Robozor-network/Opticus/README.md

# Opticus

Opticus black line following robot. 

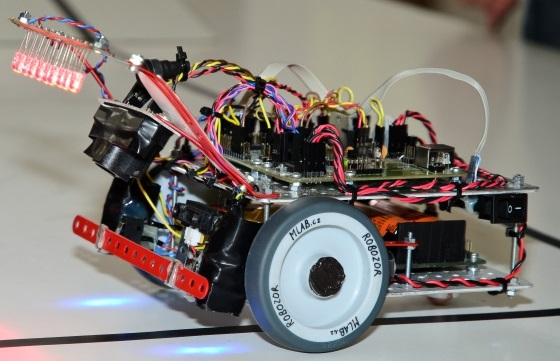
[picture p1: Opticus_Small.jpg]
Robot Opticus
