Robozor-network/Opticus/CAD/wheel.stl

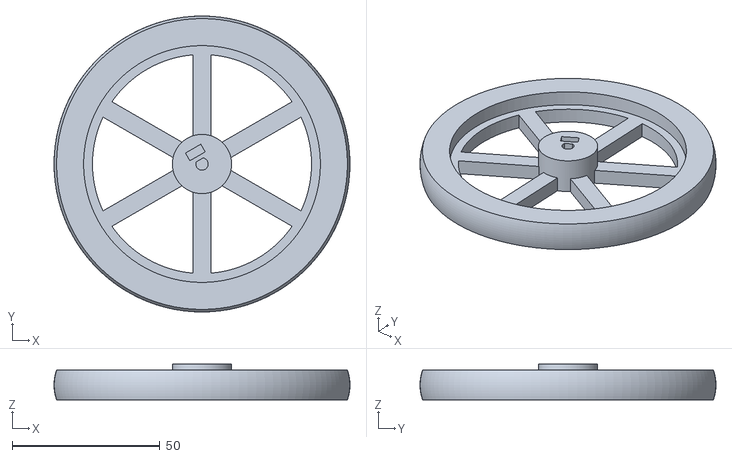
[picture p24: CAD file, 2015-09-17]
CAD/wheel.stl
100.0 x 100.0 x 12.0
