Robozor-network/Opticus/(commit log)

2013-12-01 sensor testing.
2013-12-02 testovaci program pro vycitani mereni ze sensoru.
2013-12-23 zalozeni nove dokumentacni slozky pro dvoukanalovy ADC.
2014-01-05 Hodinový PLL generátor s obvodem TI CDCE913 (schema, PCB a technologické výstupy).
2014-01-09 Opraven SCH a PCB CLK1PLL01A (oprava EN vývodů u stabilizátorů), nutno ještě přegenerovat PDF výstupy od plošného spoje (zde PDF995 generuje velmi nekvalitní výstupy, nutno použít něco funkčnějšího).
2014-02-04 ve firmwaru AWS odstranen aktualni cas. Je overena funkce i2c slave. Je treba doplnit relativni casove mereni. A aktualizaci registru.
2014-02-08 Nový modul AVRUSB01A pro SW realizaci USB na AVR, umí ISP programování, nebo USB na I2C
2014-02-15 Doladěny přepínače FUSE pro procesory ATmega8 a ATmega88
2014-02-23 zavedeni modulu i2chub.
2014-02-26 pridani navrhu v KiCAD.
2014-03-02 Původní verze firmwaru (pro referenci změn) i2c-tiny-usb pro modul AVRUSB01
2014-03-02 Upravená verze firmwaru i2c-tini-usb pro modul AVRUSB01
2014-03-02 Překlad firmwaru I2C pro AVRUSB01 (plus oprava pro překlad pod Linuxem)
2014-03-06 aktualizace kodu pro novou verzi I2C knihoven.
2014-03-10 pridani navrhu differencniho vstupu pro adc ve zvukovce.
2014-03-12 zaznam chyb na PCB.
2014-03-16 dokoncovani navrhu plosneho spoje pro FMC redukci (pridany koty). Zacatek navrhu modulu pro ADC.
2014-03-18 prvni optimalizace differencnich spoju. A prohozeni polarity vstupu ADC.
2014-03-19 pridani zapomenutych souboru a uprava skriptu pro prejmenovani vystupu z KiCADu.
2014-03-24 Added an utility for setting Si570 without frequency measurement. Factory calibration is used.
2014-03-30 pridani ipython navodu pro magnetometr.
2014-04-08 Přidána podpora jak společné anody tak i společné katody LED displeje.
2014-04-17 rozdeleni konstrukce AWS01B na novou vyvojovou vetev AWS02A, ktera se uz nepripojuje pres RS323, ale pres I2C.
2014-04-24 Uprava kodu pro puziti s Odroidem a I2C hubem.
2014-04-29 Dokumentace malého napájecího zdroje NTPI2EU 9V/500mA (rozpracováno)
2014-05-02 Dokumentace malého napájecího zdroje NTPI2EU 9V/500mA (dokončeno)
2014-05-25 I2C motor driver
2014-05-26 pridani regulatoru.
2014-06-07 add Fritzing GPS antenna
2014-06-16 pridani schema sensoru smeru vetru meteostanice.
2014-08-17 Pridan navod na regulator.
2014-08-21 schema I2CSPI
2014-10-25 Added LED heartbeat indicator.
2014-11-24 oprava zapojeni vstupnich konektoru ADC modulu.
2014-11-26 Added High Voltage Source for Gas Lamps
2014-11-30 Added values to schematic.
2014-12-08 Change of holes arrangement
2014-12-09 uprava pcb
2014-12-11 zaroutovani PCB.
2015-01-02 oprava chyby - misto pro kondenzatory na redukcnim PCB.
2015-01-11 zlepšeny tolerance PCB.
2015-01-16 editace podlozky pro lepsi geometrii a usetreni materialu.
2015-02-03 zlepseni dokumentace. Pokus o vytvoreni sablony KiCAD, ktera by umoznila kresleni plosnych spoju v prvnim kvadrantu.
2015-02-13 pridani dokumentacni slozky pro Raspberry Pi podlozku.
2015-02-15 prvni verze drzaku na raspberry Pi.
2015-02-16 pridan obrazek ramecku pro Raspberry.
2015-02-22 pridani obrazku pouziteho drzaku na Raspberry.
2015-03-06 zaroutovani casti PCB po posunuti der a okraje
2015-03-11 zmena pouzder u kondenzatoru a diod.
    V teto verzi je taky omylem aktualizovany footprint pro 2mm hrebinek, coz zpusobilo problem diky zmene cislovani.
2015-03-16 Prvni verze breakout frame pro Intel Galileo.
2015-03-19 Pridani fotky breakout frame pro Intel Galileo.
2015-03-25 upravy PCB a vygenerovani technologickych dat.
2015-03-25 doladeni routovani PCB.
2015-04-06 Modernizace PCB.
2015-04-23 Better LED status indication.
2015-05-04 upravy popisku a cest pro lepsi vedeni GND.
2015-06-18 ADC version of dosimeter
2015-06-19 shorten LED blink
2015-07-18 An temperature real time plot using HTML5
2015-08-17 okotovani PCB.
2015-08-27 USBHUB01A PCB
2015-09-08 zalozeni noveho modulu pro tenzometricky ADC.
2015-09-10 Uprava tisknutelneho kola pro prisroubovani na D-cut.
    [wheel.scad, wheel.stl]
2015-09-11 drobne opravy PCB.
2015-09-14 upravy rozmeru kola podle skutecneho vytisku.
    [wheel.scad]
2015-09-15 Modifikace kola pro snadnejsi tisk.
    [wheel.scad, wheel.stl]
2015-09-15 Posunuti PCB do stredu stranky pri tisk dokumentace.
2015-09-16 uprava parametru kola pro lepsi tisk.
    [wheel.scad, wheel.stl]
2015-09-16 optimalizace pro tisk.
    [wheel.scad, wheel.stl]
2015-09-17 uprava prumeru hridele podle nastaveni tiskarny.
    [wheel.scad, wheel.stl]
